RASITH7/MPPT-Solar-Charger-with-Advanced-Control-and-Monitoring/PCB/front side_soldered.jpg

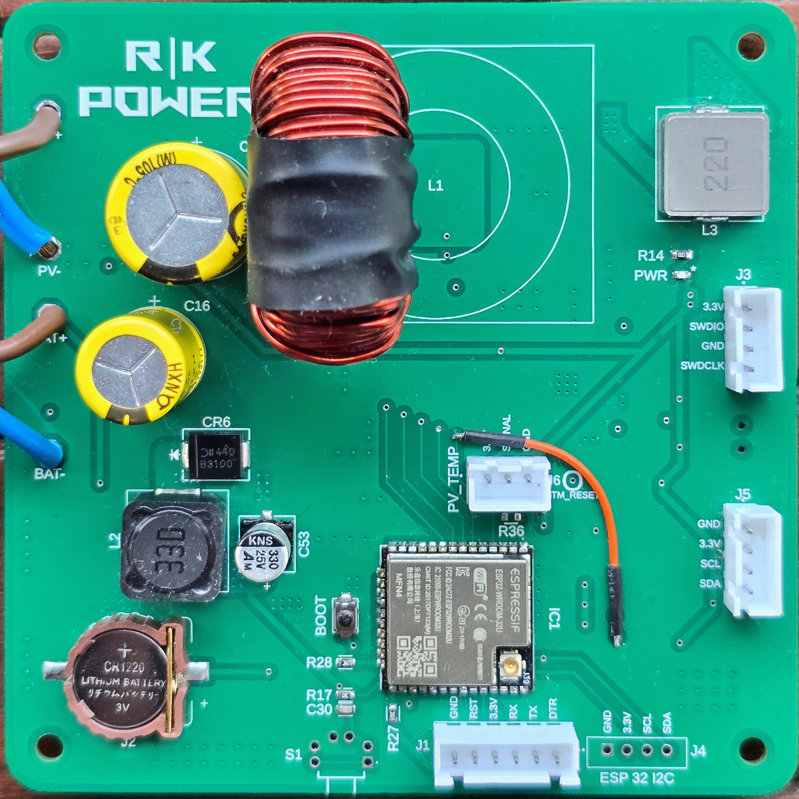
PCB/front side_soldered.jpg
