RASITH7/MPPT-Solar-Charger-with-Advanced-Control-and-Monitoring/ANN_ML/actual_vs_predicted.png

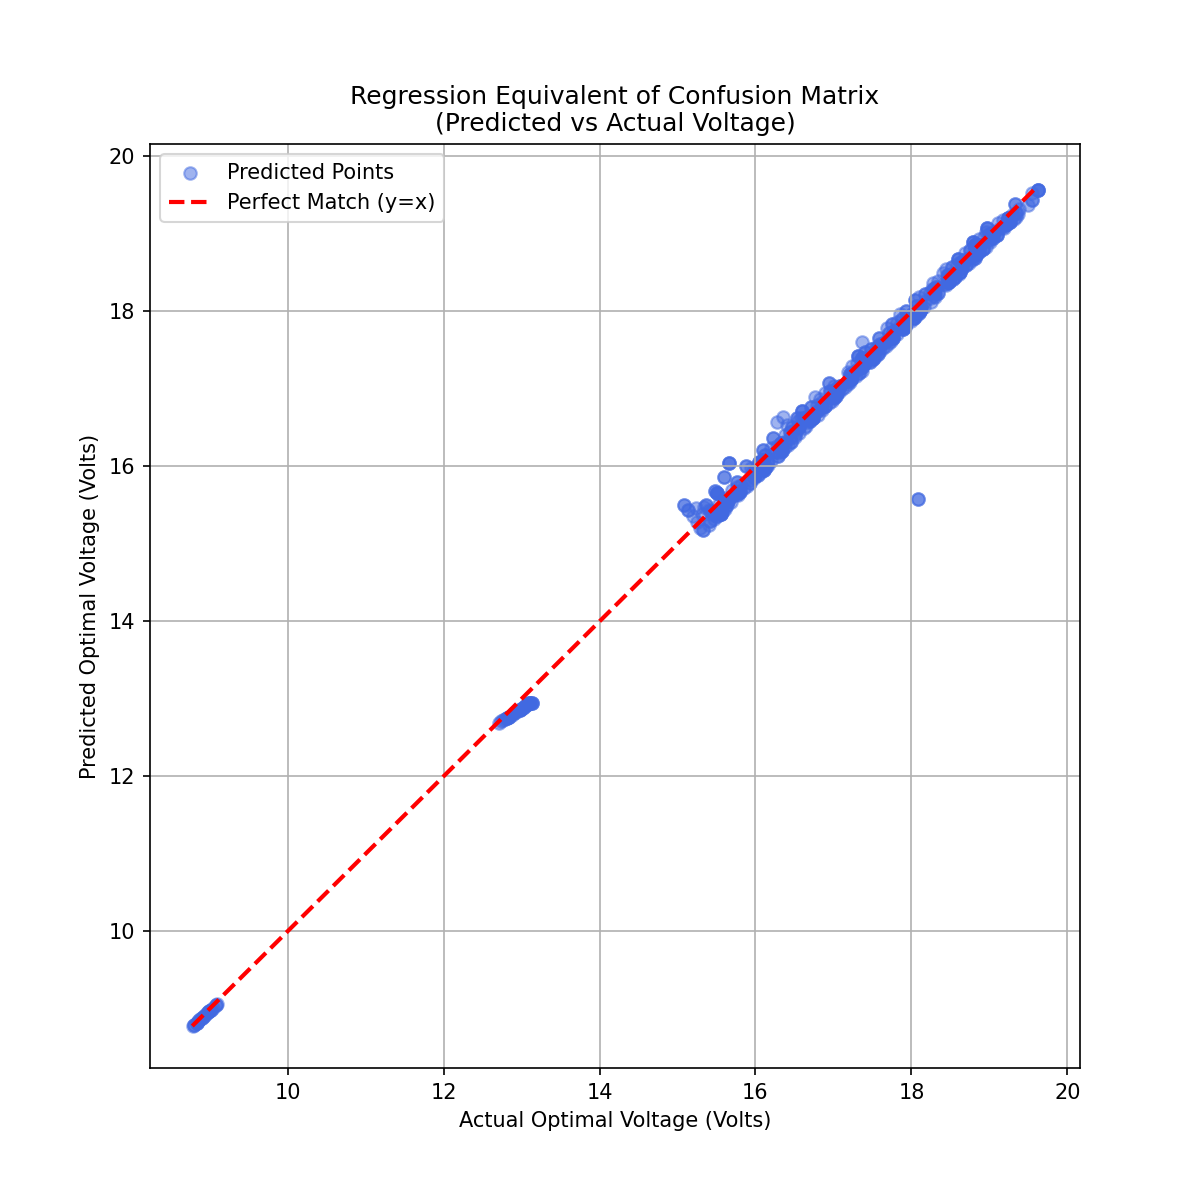
ANN_ML/actual_vs_predicted.png
