RASITH7/MPPT-Solar-Charger-with-Advanced-Control-and-Monitoring/ANN_ML/FYP_Loss_Curve.png

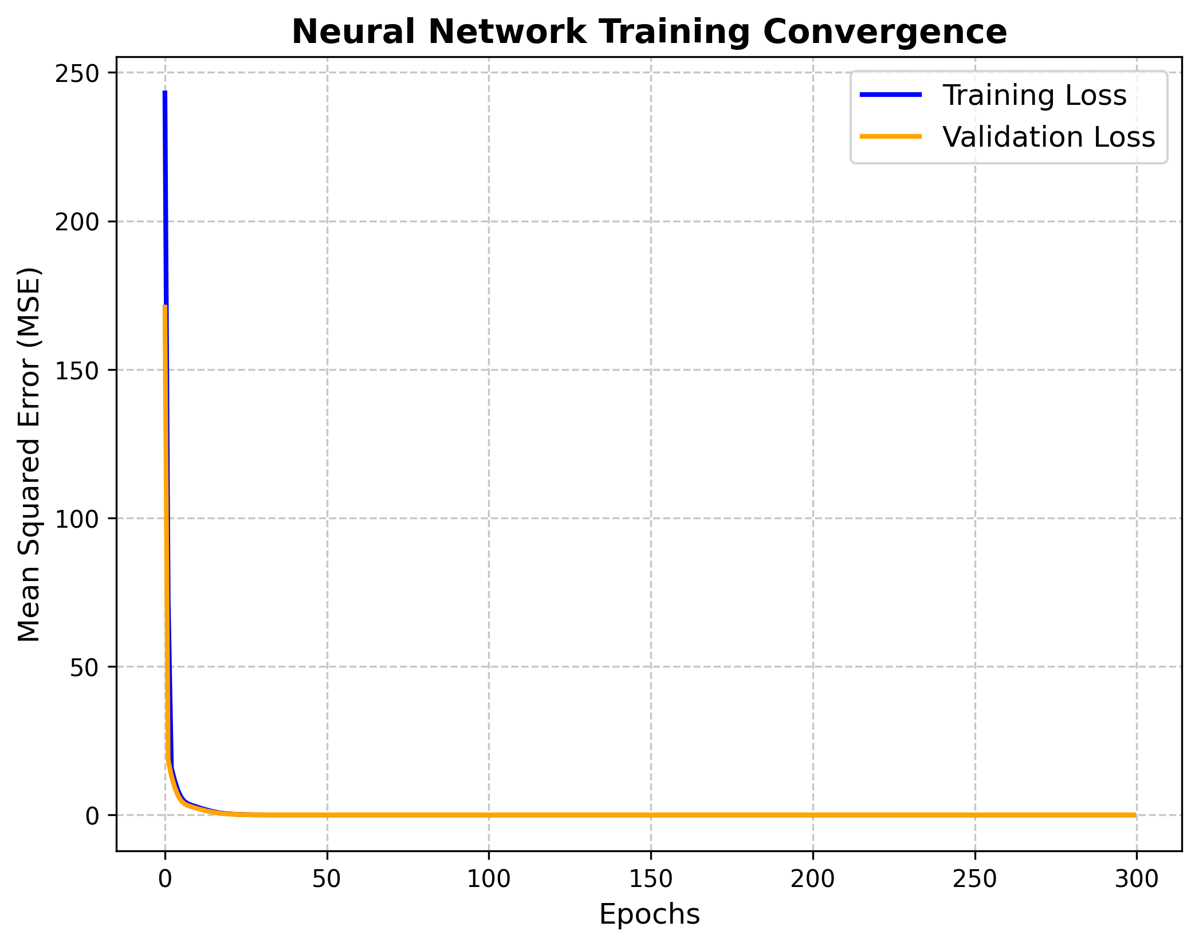
ANN_ML/FYP_Loss_Curve.png
