RASITH7/MPPT-Solar-Charger-with-Advanced-Control-and-Monitoring/PCB/Bottom_3d.png

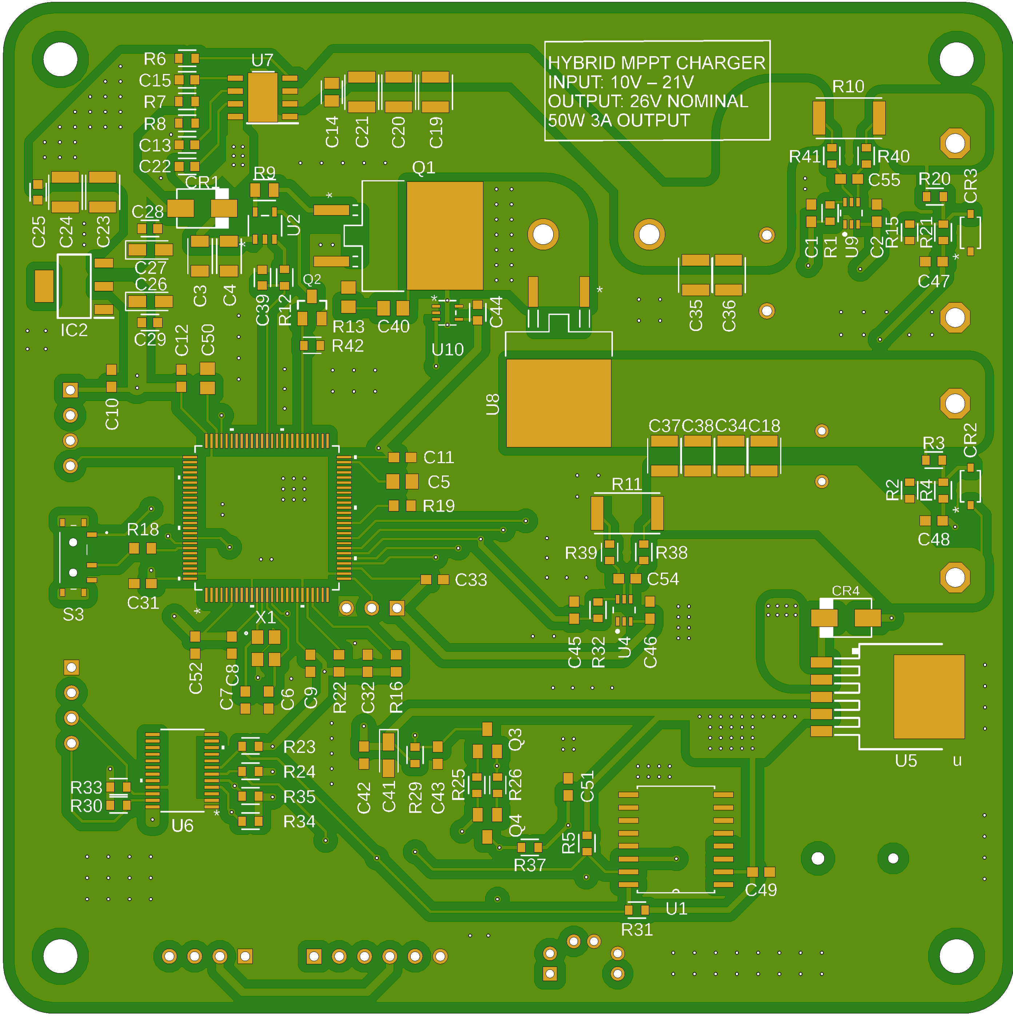
PCB/Bottom_3d.png
