RASITH7/MPPT-Solar-Charger-with-Advanced-Control-and-Monitoring/PCB/Top_3d.png

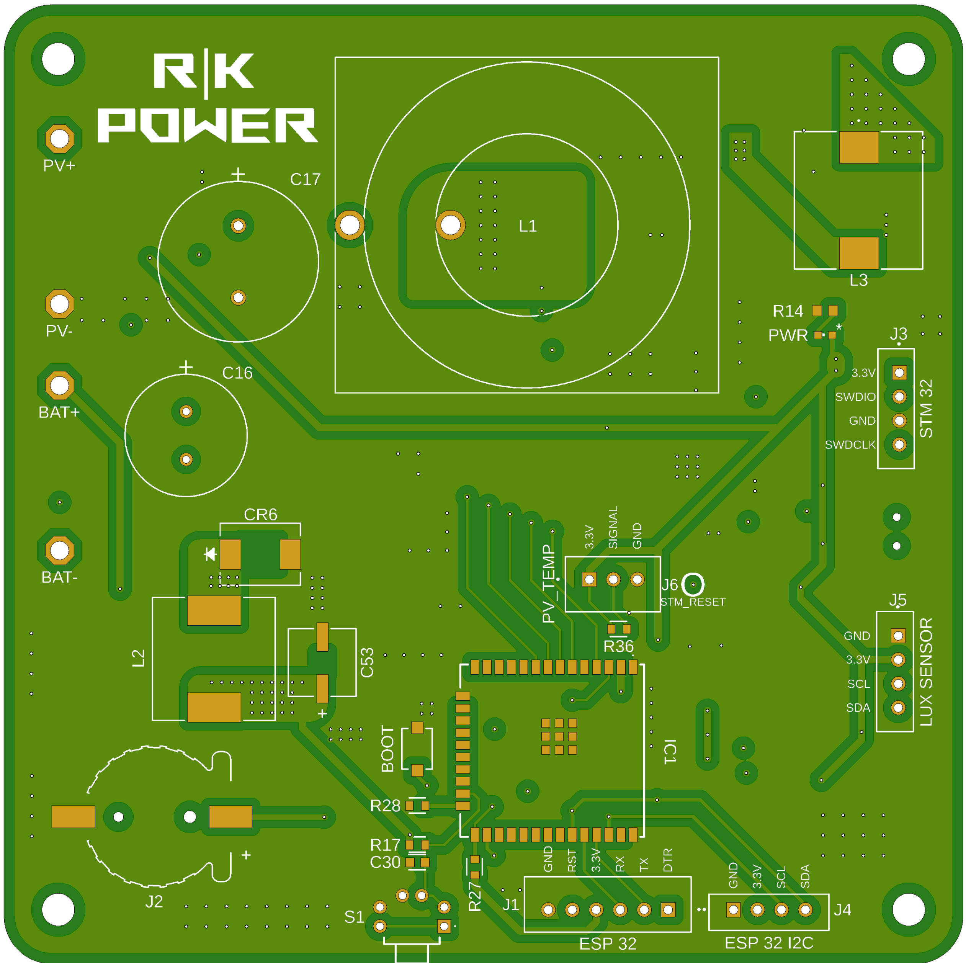
PCB/Top_3d.png
