RASITH7/MPPT-Solar-Charger-with-Advanced-Control-and-Monitoring/SIMULINK_CIRCUIT_Simulation/FLC/Screenshot 2026-04-21 150732.png

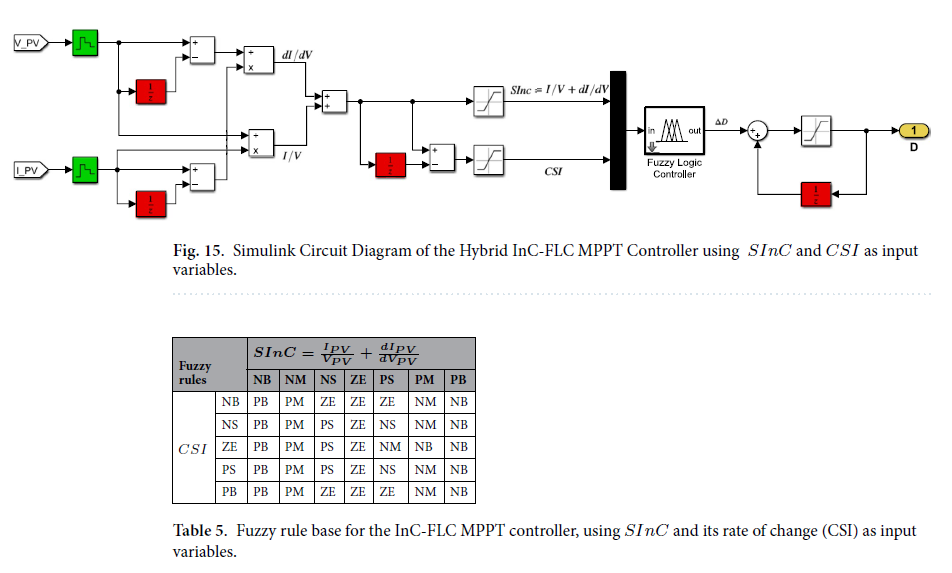
SIMULINK_CIRCUIT_Simulation/FLC/Screenshot 2026-04-21 150732.png
