RASITH7/MPPT-Solar-Charger-with-Advanced-Control-and-Monitoring/SIMULINK_CIRCUIT_Simulation/IC/INC.png

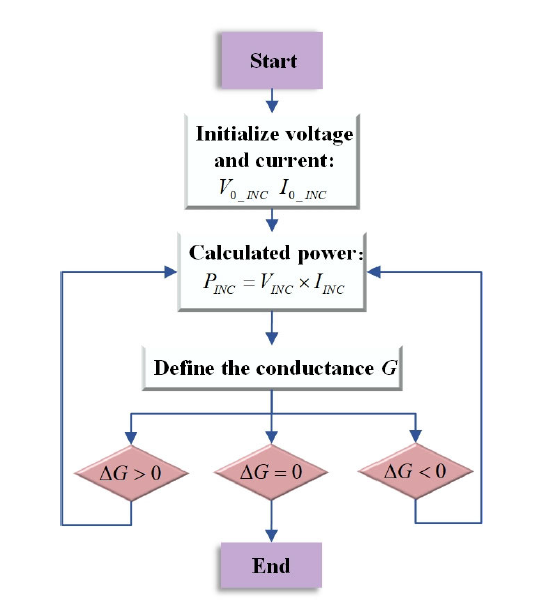
SIMULINK_CIRCUIT_Simulation/IC/INC.png
