RASITH7/MPPT-Solar-Charger-with-Advanced-Control-and-Monitoring/SIMULINK_CIRCUIT_Simulation/P&O/Screenshot 2026-05-23 133309.png

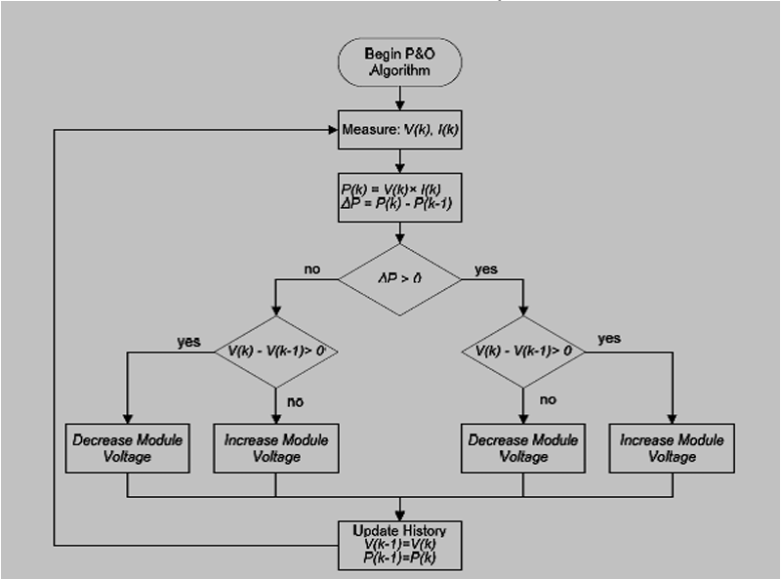
SIMULINK_CIRCUIT_Simulation/P&O/Screenshot 2026-05-23 133309.png
