RASITH7/MPPT-Solar-Charger-with-Advanced-Control-and-Monitoring/PCB/Final_MPPT.pdf

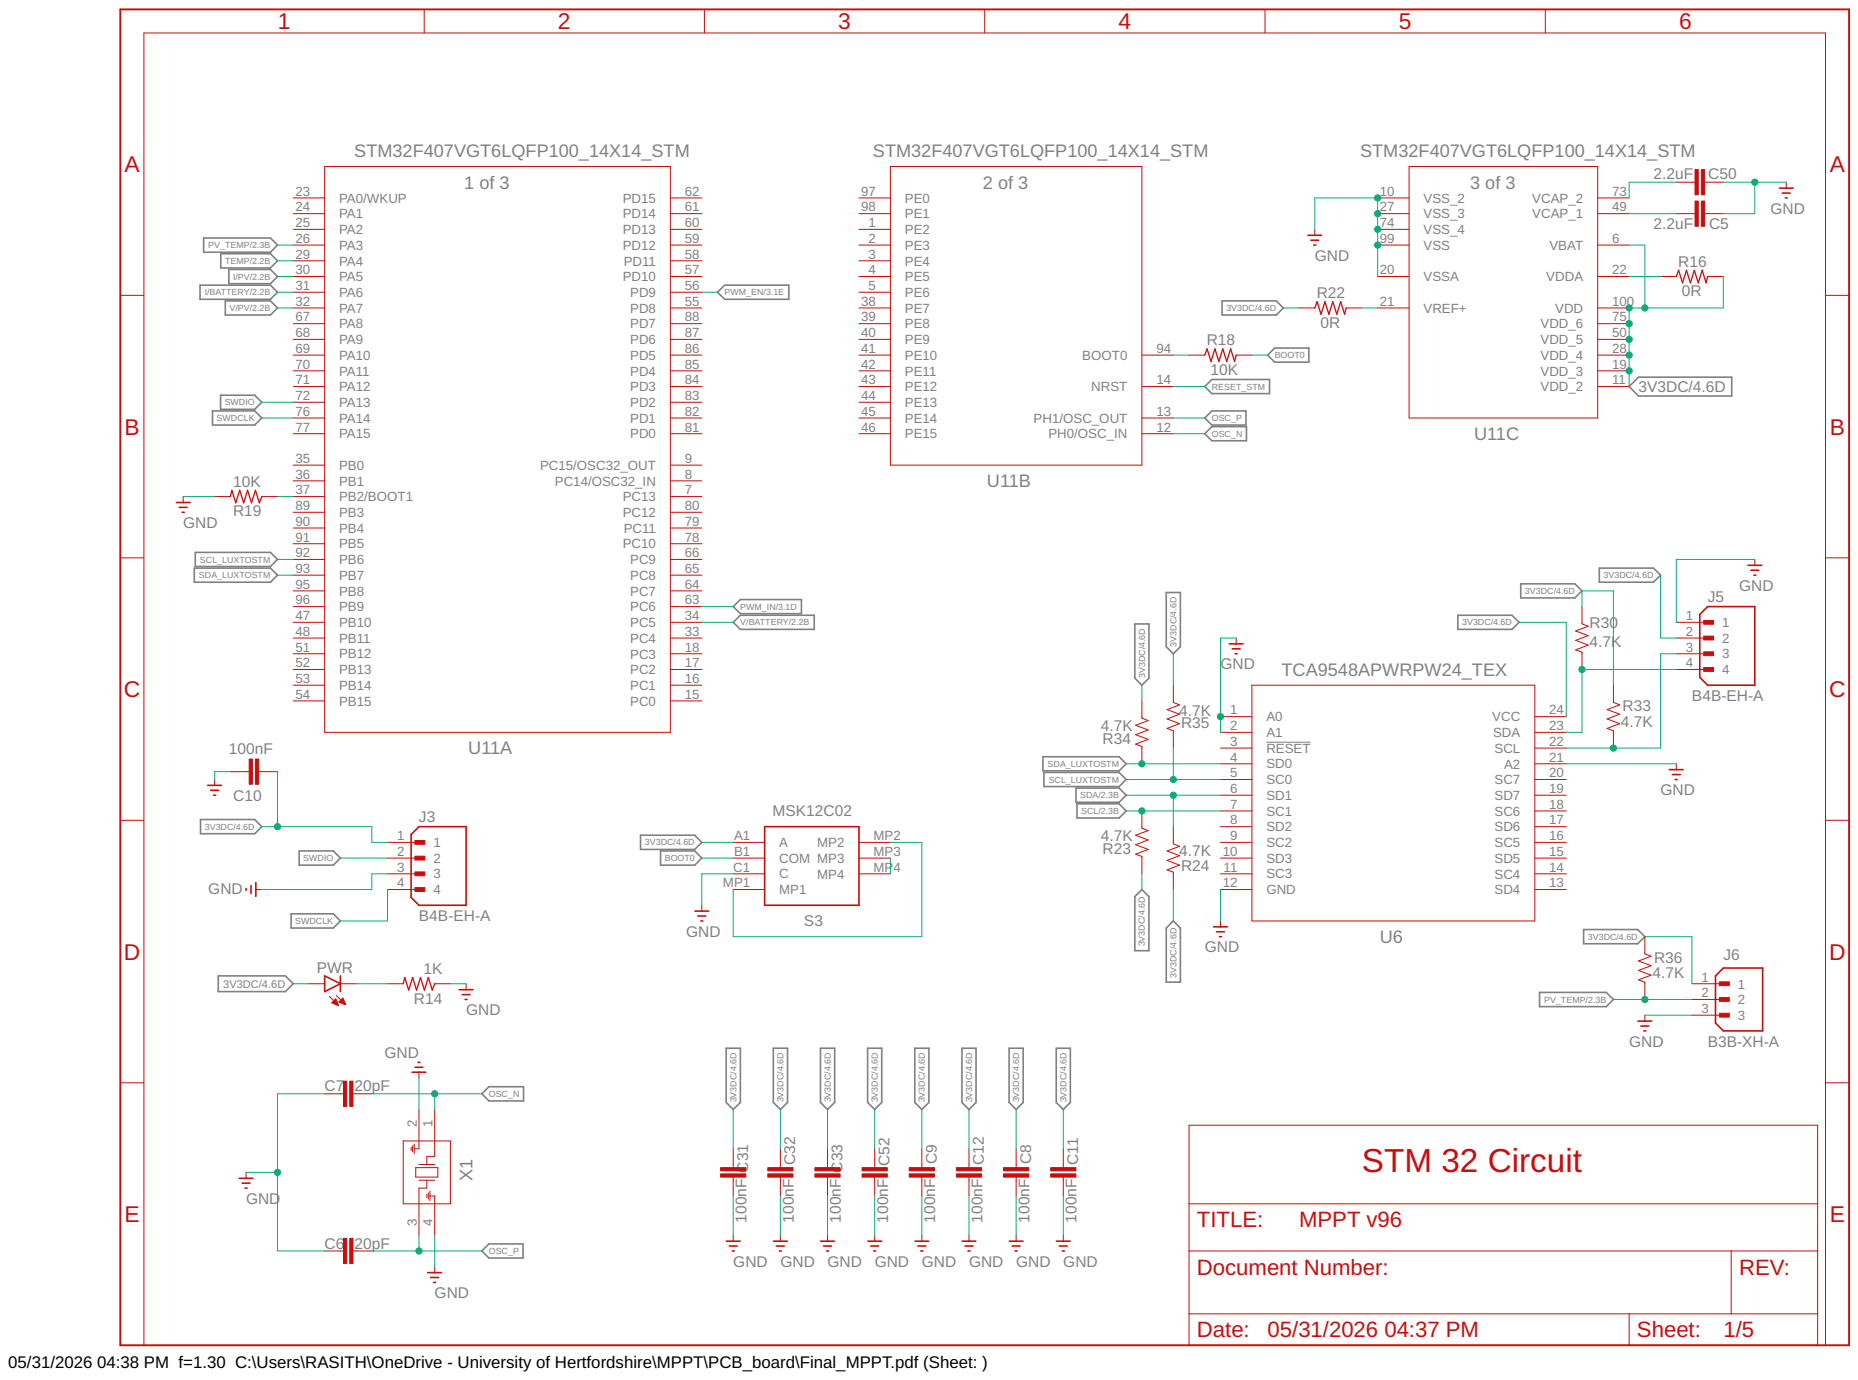
[picture p9: page 1]

GND GND

Document Number: GND GND GND GND

REV:

Date: 05/31/2026 04:37 PM | Sheet: 1/5

05/31/2026 04:38 PM f=1.30 C:\Users\RASITH\OneDrive - University of Hertfordshire\MPPT\PCB_board\Final_MPPT.pdf (Sheet: )

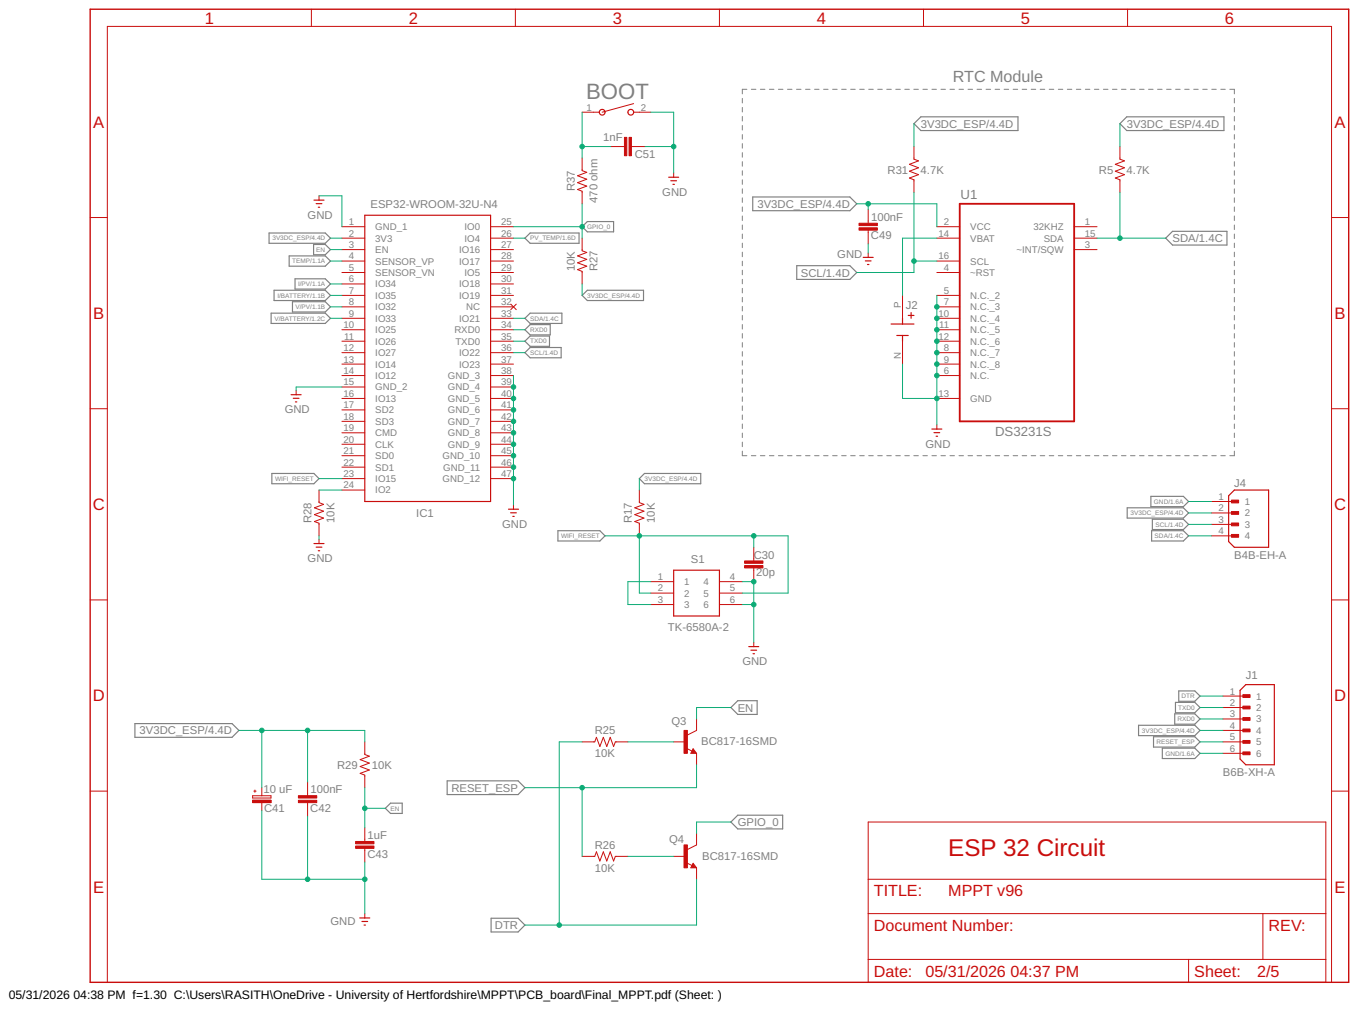
[picture p10: page 2]

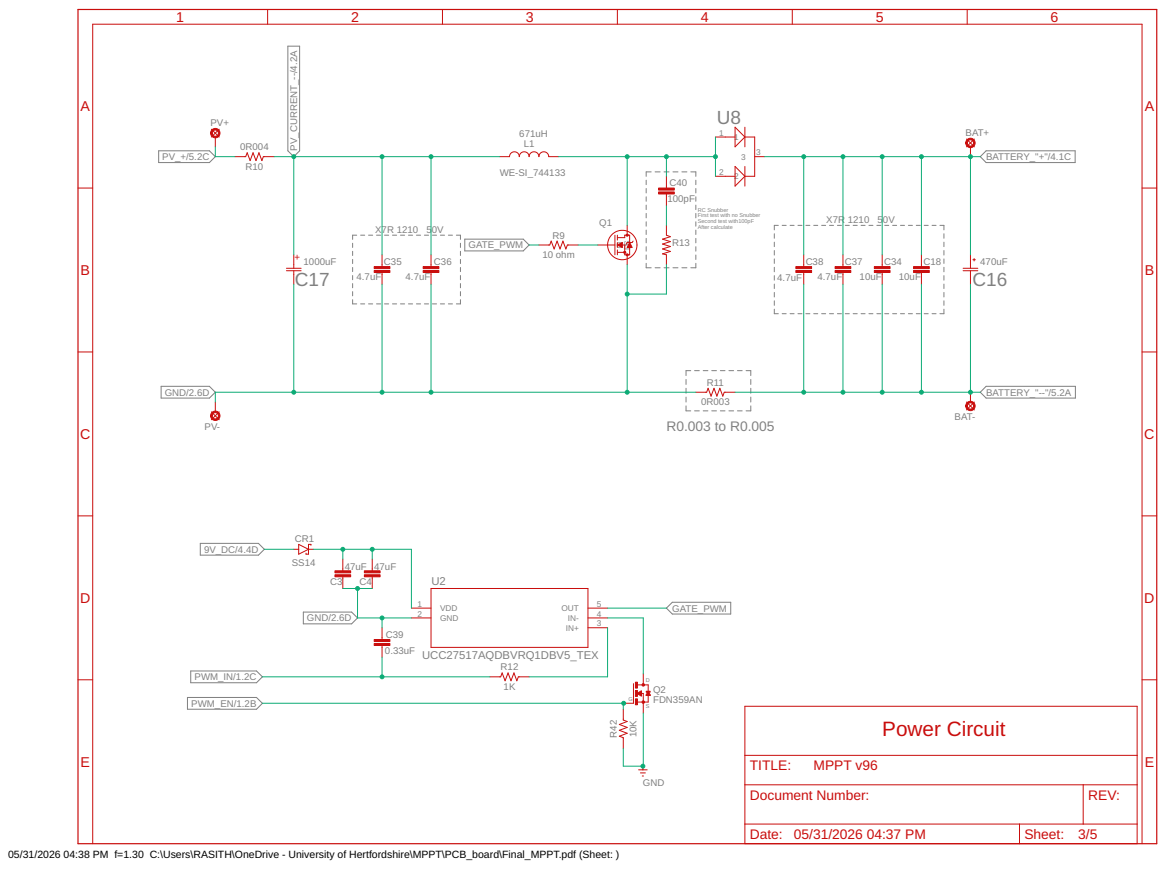
[picture p11: page 3]

RC Snubber First test with no Snubber Second test with100pF After calculate X7R 1210 50V

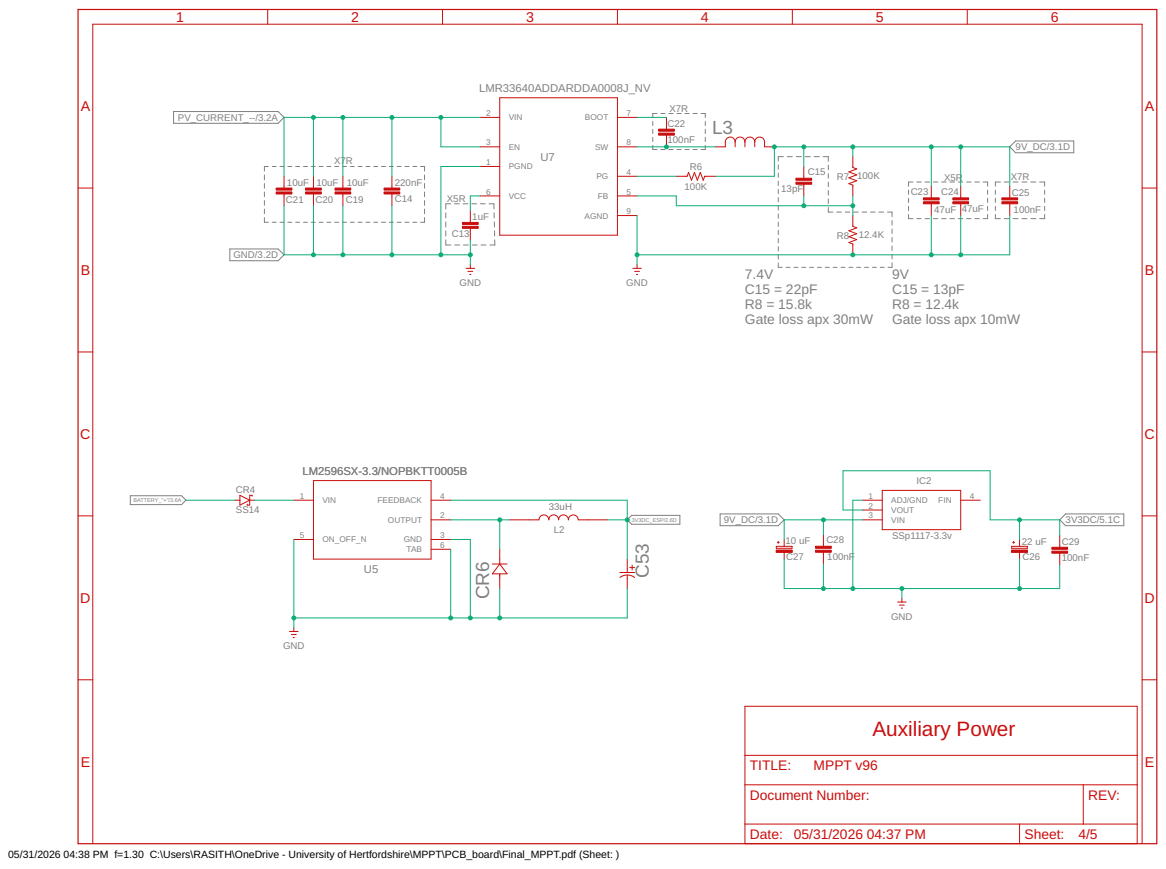
[picture p12: page 4]

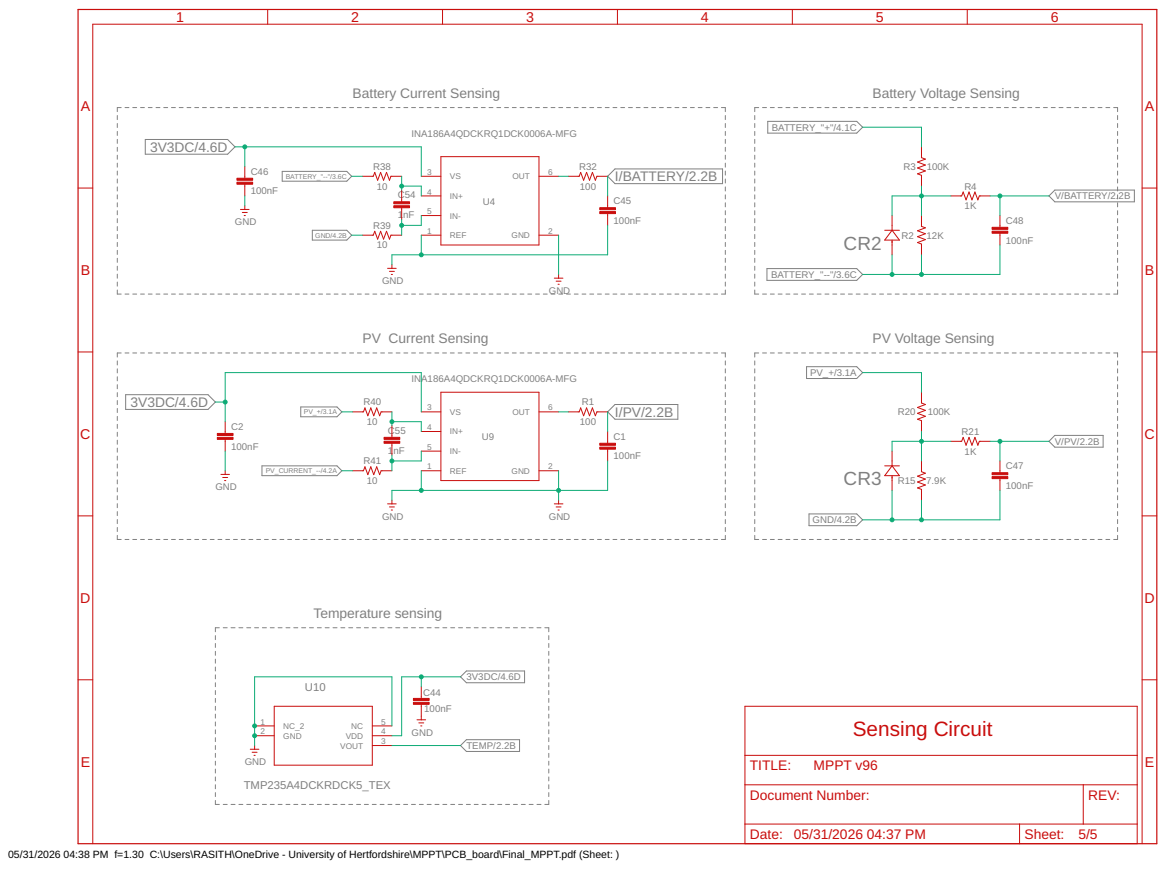
[picture p13: page 5]
