RASITH7/MPPT-Solar-Charger-with-Advanced-Control-and-Monitoring/STM32/IC_Algorithem/Core/Src/main.c

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
/* Includes ------------------------------------------------------------------*/
#include "main.h"
#include <math.h> // Needed for fabs()

ADC_HandleTypeDef hadc1;
DMA_HandleTypeDef hdma_adc1;

TIM_HandleTypeDef htim8;

/* USER CODE BEGIN PV */
// Raw ADC values updated automatically by DMA
// [0]=V_pv, [1]=I_pv, [2]=V_bat, [3]=I_bat, [4]=Irr, [5]=Temp
volatile uint32_t adc_values[6];

// Float array to hold the calculated real-world values for Live Expressions
volatile float actual_values[6];

// --- MPPT Persistent Variables ---
float V_prev = 0.0f;
float I_prev = 0.0f;
float D_prev = 0.15f; // Start at D_min

// Timing variable for MPPT execution rate
uint32_t last_mppt_run_time = 0;

// State variable for Under-Voltage Lockout (UVLO)
uint8_t system_is_active = 0; // 0 = OFF, 1 = ON
/* USER CODE END PV */

void SystemClock_Config(void);
static void MX_GPIO_Init(void);
static void MX_DMA_Init(void);
static void MX_ADC1_Init(void);
static void MX_TIM8_Init(void);
/**
  * @brief  The application entry point.
  * @retval int
  */
int main(void)
{
  /* MCU Configuration--------------------------------------------------------*/

  /* Reset of all peripherals, Initializes the Flash interface and the Systick. */


	HAL_Init();

  /* Configure the system clock */
  SystemClock_Config();

  /* Initialize all configured peripherals */
  MX_GPIO_Init();
  MX_DMA_Init();
  MX_ADC1_Init();
  MX_TIM8_Init();

  /* USER CODE BEGIN 2 */

  // Keep Gate Driver OFF initially for safety
  HAL_GPIO_WritePin(GPIOD, GPIO_PIN_9, GPIO_PIN_RESET);

  if (HAL_TIM_PWM_Start(&htim8, TIM_CHANNEL_1) != HAL_OK)
  {
      Error_Handler();
  }

  // Start the ADC in DMA mode
  HAL_ADC_Start_DMA(&hadc1, (uint32_t*)adc_values, 6);

  /* USER CODE END 2 */

  /* Infinite loop */
  /* USER CODE BEGIN WHILE */
  while (1)
  {
	  //this is normal pv soalr
      // --- CALIBRATION MATH ---
      actual_values[0] = (0.0076146f * (float)adc_values[0]) - 0.0804105f; // V_PV
      actual_values[1] = (0.0014478f * (float)adc_values[1]) - 0.1090731f; // I_PV
      actual_values[2] = (0.0111027f * (float)adc_values[2]) - 0.1062549f; // V_BATT add another resistor
      actual_values[3] = (0.0012095f * (float)adc_values[3]) + 0.1003010f; // I_BATT
      actual_values[4] = (44.2522078f * (float)adc_values[4]) - 144.5912166f; // PV_Irradiance (Lux)
      actual_values[5] = (0.0802774f  * (float)adc_values[5]) - 5.0963303f;  // PV_Temperature (C)

      // Clamp negative values to 0 for cleaner math
      for(int i = 0; i < 4; i++) {
          if (actual_values[i] < 0.0f) actual_values[i] = 0.0f;
      }

      // --- UNDER-VOLTAGE LOCKOUT (WITH HYSTERESIS) ---
      // If the system is currently ON, but voltage drops below 10V -> Turn OFF
      if (system_is_active == 1 && actual_values[0] < 10.0f)
      {
          system_is_active = 0;
      }
      // If the system is currently OFF, wait until voltage rises above 12V to turn back ON
      else if (system_is_active == 0 && actual_values[0] > 12.0f)
      {
          system_is_active = 1;
      }

      // --- EXECUTE BASED ON SYSTEM STATE ---
      if (system_is_active == 0)
      {
          // SYSTEM OFF: Voltage is too low (Night time / heavy shade)
          HAL_GPIO_WritePin(GPIOD, GPIO_PIN_9, GPIO_PIN_RESET); // Disable Gate Driver
          __HAL_TIM_SET_COMPARE(&htim8, TIM_CHANNEL_1, 0);      // Set PWM to 0%

          // Reset MPPT variables so it starts fresh when the sun comes back
          D_prev = 0.15f;
          V_prev = actual_values[0];
          I_prev = actual_values[1];
      }
      else
      {
          // SYSTEM ON: Sun is up and voltage is stable
          HAL_GPIO_WritePin(GPIOD, GPIO_PIN_9, GPIO_PIN_SET);   // Enable Gate Driver

          // --- INCREMENTAL CONDUCTANCE MPPT ALGORITHM ---
          // Run the MPPT logic every 10 milliseconds (100 Hz sampling rate)
          if (HAL_GetTick() - last_mppt_run_time >= 10)
          {
              last_mppt_run_time = HAL_GetTick();

              float V = actual_values[0];
              float I = actual_values[1];
              float duty = D_prev;

              float deltaD = 0.002f;
              float D_max = 0.85f;
              float D_min = 0.15f;
              float tol = 0.4f;

              // Prevent division by zero
              if (V < 0.1f) V = 0.1f;

              float dV = V - V_prev;
              float dI = I - I_prev;

              if (fabs(dV) < 0.01f) // Floating point safety
              {
                  if (fabs(dI) < 0.01f) {
                      duty = D_prev;
                  } else if (dI > 0) {
                      duty = D_prev - deltaD;
                  } else {
                      duty = D_prev + deltaD;
                  }
              }
              else
              {
                  float G = I / V;
                  float dG = dI / dV;

                  if (fabs(dG + G) < tol) {
                      duty = D_prev;
                  } else if (dG > -G) {
                      duty = D_prev - deltaD;
                  } else {
                      duty = D_prev + deltaD;
                  }
              }

              // Apply Duty Cycle Limits
              if (duty > D_max) duty = D_max;
              if (duty < D_min) duty = D_min;

              // Update state variables for next cycle
              V_prev = V;
              I_prev = I;
              D_prev = duty;

              // Apply to Hardware Timer (Multiply 0.0-1.0 by 100 for the Timer ARR)
              uint32_t timer_compare_value = (uint32_t)(duty * 100.0f);
              __HAL_TIM_SET_COMPARE(&htim8, TIM_CHANNEL_1, timer_compare_value);
          }
      }

      // Small delay just to prevent CPU maxing out
      HAL_Delay(1);

    /* USER CODE END WHILE */

    /* USER CODE BEGIN 3 */
  }
  /* USER CODE END 3 */
}

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
