RASITH7/MPPT-Solar-Charger-with-Advanced-Control-and-Monitoring/STM32/ANN_Plus_PI_Algorithem/ANN_Plus_PI_Algorithem.ioc

Mcu.UserName=STM32F407VGTx
PA13.Signal=SYS_JTMS-SWDIO
PA14.Signal=SYS_JTCK-SWCLK
PA3.GPIO_Label=PA3 / PV_temperature
PA3.Signal=ADCx_IN3
PA4.GPIO_Label=PA4 / PV_Irradiance
PA4.Signal=ADCx_IN4
PA5.GPIO_Label=PA5 / I_pv
PA5.Signal=ADCx_IN5
PA6.GPIO_Label=PA6 / I_battery
PA6.Signal=ADCx_IN6
PA7.GPIO_Label=PA7 / V_pv
PA7.Signal=ADCx_IN7
PC5.GPIO_Label=PC5 / V_battery
PC5.Signal=ADCx_IN15
PC6.Signal=S_TIM8_CH1
PD9.Signal=GPIO_Output
PH0-OSC_IN.Signal=RCC_OSC_IN
PH1-OSC_OUT.Signal=RCC_OSC_OUT
