RASITH7/MPPT-Solar-Charger-with-Advanced-Control-and-Monitoring/STM32/IC_Algorithem/Core/Inc/main.h

#define PA3___PV_temperature_Pin GPIO_PIN_3
#define PA3___PV_temperature_GPIO_Port GPIOA
#define PA4___PV_Irradiance_Pin GPIO_PIN_4
#define PA4___PV_Irradiance_GPIO_Port GPIOA
#define PA5___I_pv_Pin GPIO_PIN_5
#define PA5___I_pv_GPIO_Port GPIOA
#define PA6___I_battery_Pin GPIO_PIN_6
#define PA6___I_battery_GPIO_Port GPIOA
#define PA7___V_pv_Pin GPIO_PIN_7
#define PA7___V_pv_GPIO_Port GPIOA
#define PC5___V_battery_Pin GPIO_PIN_5
#define PC5___V_battery_GPIO_Port GPIOC
