RASITH7/MPPT-Solar-Charger-with-Advanced-Control-and-Monitoring/(notices)

Notices in the files:
STM32/IC_Algorithem/Core/Inc/main.h:
Copyright (c) 2026 STMicroelectronics.
All rights reserved.
This software is licensed under terms that can be found in the LICENSE file
